AchimPieters/microduck-build/notes/fotos-look-vergelijking.jpg

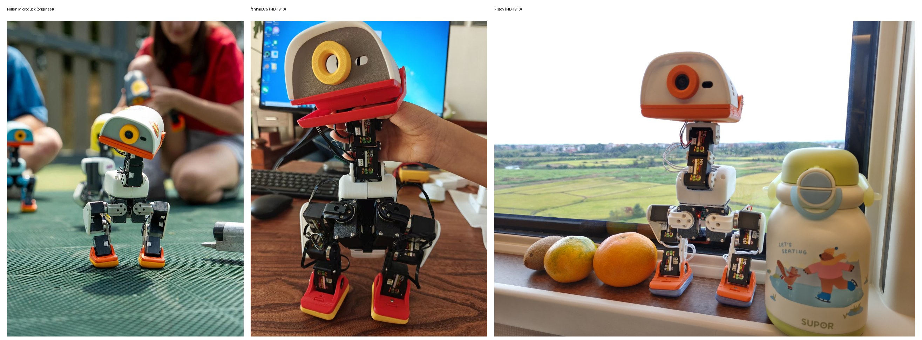
notes/fotos-look-vergelijking.jpg
