AchimPieters/microduck-build/README.md

# Building a micro-Duck

Notes, files and blog drafts for my build of a **Pollen Robotics Microduck** replica, using the [kissqy/Microduck-kissqy](https://github.com/kissqy/Microduck-kissqy) design (Feetech HD-1910 servos, Radxa ZERO 3W).

Website: <https://www.studiopieters.nl>

## The blog series

| Part | Article |
|---|---|
| 1 | [Building a micro-Duck, Part 1: The Plan](https://www.studiopieters.nl/microduck-build-part-1-the-plan/) |
| 2 | [Building a micro-Duck, Part 2: The Hardware](https://www.studiopieters.nl/microduck-build-part-2-the-hardware/) |
| 3 | [Building a micro-Duck, Part 3: Printing the Parts](https://www.studiopieters.nl/microduck-build-part-3-printing-the-parts/) |
| 4 | [Building a micro-Duck, Part 4: Too Many Ducks](https://www.studiopieters.nl/microduck-build-part-4-too-many-ducks/) |
| 5 | [Building a micro-Duck, Part 5: Starting Over, the Right Way](https://www.studiopieters.nl/microduck-build-part-5-starting-over/) |

Parts 1 to 3 describe an earlier plan (the XGO-Duck). From Part 5 on, the build follows the kissqy design.

## What is in this repository

| Folder | Contents |
|---|---|
| `print-files/` | The FrankenDuck 3D print set (36 STL files and a 3MF plate layout) with English file names. `NAME-MAP.txt` lists the original Chinese names. |
| `notes/` | My research notes, build plan and order list (in Dutch). |
| `blog/` | Markdown drafts of Parts 1, 2 and 4. |
| `CLAUDE.md` | Goals, rules and status of the project, used as instructions for Claude Code. |

## Credits and licenses

- The print files, HAT, IMU, HUB, console and walking models are by [kissqy](https://github.com/kissqy/Microduck-kissqy), who allows **personal, non-commercial use only**. See the [license](https://github.com/kissqy/Microduck-kissqy/blob/main/LICENSE). I only renamed the files to English. This repository is private. Check the license before making it public.
- The Microduck is a design by [Pollen Robotics](https://github.com/pollen-robotics/microduck).
- My own notes and drafts are mine.
