AchimPieters/microduck-build/bestellijst-kissqy.md

# Bestellijst: kissqy Microduck (HD-1910)

Opgesteld op 2026-10-31 uit kissqy's [boodschappenlijst](https://github.com/kissqy/Microduck-kissqy/blob/main/DUCK-SHOPPING-LIST.en.md) en bijbehorende gegevens (`docs/build/data.json`). De links verwijzen naar de Taobao- en JD-pagina's van de auteur. Kies op de pagina de **exacte variant (SKU)** uit de kolom "Variant". Prijzen zijn de historische prijzen van de auteur in ¥ en kunnen veranderen. Winkels kunnen uitverkocht raken.

De kosten laat ik buiten beschouwing. Dat hangt af van waar je woont en welke doorstuurservice je kiest.

## A. Via je doorstuurservice (Taobao en JD)

| # | Onderdeel | Aantal | Variant (kies op de pagina) | Link |
|---|---|---:|---|---|
| 1 | Feetech **HD-1910-C001** servo | 15 | HD-1910-C001 | [Taobao](https://item.taobao.com/item.htm?id=1078248851201) |
| 2 | **HAT**, kant-en-klaar | 1 | **AMP2.0-versie** (zie punt hieronder). Bevestig bij de bestelling het type servobus-, speaker- en microfoonconnector | [Taobao](https://item.taobao.com/item.htm?id=1095121548583) |
| 3 | **IMU**, kant-en-klaar (voorgeflasht FT6) | 1 | AMP2.0-versie | zelfde pagina als HAT |
| 4 | Radxa **ZERO 3W** | 1 | 2 GB RAM, geen eMMC, met pinheader (de "Microduck originele" variant) | [Taobao](https://item.taobao.com/item.htm?id=763812025816) |
| 5 | Camera **IMX219 160°** | 1 | "IMX219 160度摄像头" (SKU 6300750750661) | [Taobao](https://item.taobao.com/item.htm?id=1083291197130&skuId=6300750750661) |
| 6 | **ToF 8×8**-module (VL53L5CX) | 1 | "VL53L5X V2 module met afdekglas" | [Taobao](https://item.taobao.com/item.htm?id=737603917521) |
| 7 | Luidspreker | 1 | 3525-behuizing, 4 Ω 3 W. Kies een connector die bij de HAT past | [Taobao](https://item.taobao.com/item.htm?id=683920556900) |
| 8 | Servokabels AMP2.0 3P, **20 cm**, dubbel, omgekeerd | 30 | 200 mm / 1007 / 24 AWG / "双头反向" | [Taobao](https://item.taobao.com/item.htm?id=825340808235) |
| 9 | Servokabels AMP2.0 3P, **10 cm**, dubbel, omgekeerd | 30 | 100 mm / 1007 / 24 AWG / "双头反向" | zelfde pagina |
| 10 | Kabel SH1.0 4P naar Dupont (voor de ToF) | 1 set (5) | 0,2 m, SH1.0 4P | [Taobao](https://item.taobao.com/item.htm?id=895049863252) |
| 11 | Lagers **6700** (10 × 15 × 3 mm) | 5 | "6700 open", lagerstaal | [Taobao](https://item.taobao.com/item.htm?id=625390659071) |
| 12 | Lagers **ET2216** (16 × 22 × 4 mm) | 12 | "ET2216", lagerstaal | [Taobao](https://item.taobao.com/item.htm?id=733598659967) |
| 13 | Schroeven, zelftappend, kruiskop, plat uiteinde | 6 zakken van 200 | M2×4, M2×5, M2×6, M2×8, M2×12 en M2.6×8. Eén pagina, zes varianten | [Taobao](https://item.taobao.com/item.htm?id=534923831046) |
| 14 | Servo-programmeerbord **Feetech URT2** | 1 | URT2 (voor het instellen van servo-ID's) | [Taobao](https://item.taobao.com/item.htm?abbucket=0&id=603181554943&skuId=4836538640319) |
| 15 | Gekleurde krimpkous | 1 zak (164 stuks) | "2× krimp" | [Taobao](https://item.taobao.com/item.htm?id=945215173380) |

**Lokaal te koop in plaats van via Taobao (scheelt gewicht en gedoe):** microSD-kaart 32 GB, kaartlezer (als je er geen hebt), krimpkous.

**Let op, AMP2.0 of EH2.5:** de HAT en IMU bestaan in twee connectorversies. Kissqy's boodschappenlijst en prijzen gelden voor de oorspronkelijke **EH2.5**-versie. De HD-1910-servo's en de kabels in de lijst gebruiken **AMP2.0**. Bestel dus de **AMP2.0**-versie van HAT en IMU en lees de [AMP2.0-pagina](https://github.com/kissqy/Microduck-kissqy/blob/main/hardware/AMP2.0-VERSION.en.md) voor de extra aansluitingen (HP1.25 voor speaker en microfoon).

## B. In Nederland kopen

| Onderdeel | Aantal | Opmerking |
|---|---:|---|
| Sony **NP-F550**-accu | 2 | 2000–2200 mAh |
| Dubbele lader voor NP-F serie | 1 | USB-C of netvoeding |
| Gamepad, Xbox-modus en Bluetooth | 1 | GameSir Nova 2 Lite. Zet hem in Xbox-modus. |
| TPU-filament 95A | 250 g | Voor de twee zolen |
| PLA-filament | ca. 1 kg of meer | Kleuren naar keuze, zie `bouwplan-kissqy.md` |

## C. Vragen aan de verkoper (kissqy)

1. Verkoop je de **HUB** (DXL_HUB_V2, met condensator van 1000 µF)? Naar welke versie moet ik bestellen?
2. Welk onderdeel levert de **accucontacten** voor de NP-F550-houder, en verkoop je dat?
3. Welke versie van HAT en IMU past bij **AMP2.0-servokabels**? Zit de speakerconnector erbij?
4. Kan alles samen naar mijn **doorstuurmagazijn**?

Een kant-en-klaar bericht staat in `bouwplan-kissqy.md`.

## D. Gereedschap

Kissqy noemt gewoon assemblagegereedschap: passende kruiskopschroevendraaiers, striptang en isolatiemateriaal, en een multimeter om doorgang te controleren. Je hebt waarschijnlijk veel al. Solderen is niet nodig, want de HAT en IMU komen gemonteerd.

## E. Nog niet gevonden

- HUB: geen koopverwijzing (zie C).
- Accucontacten: onderdeel onbekend (zie C).
