AchimPieters/microduck-build/print-files/FrankenDuck-plate-layout.3mf

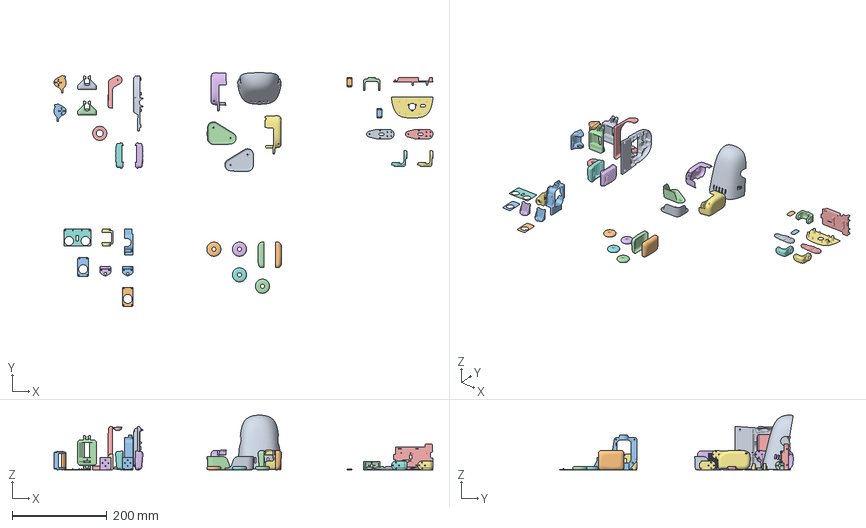
[picture p2: CAD file, 2026-10-31]
print-files/FrankenDuck-plate-layout.3mf
799.0 x 492.5 x 115.6 mm
bottom_head_shell_rear_M2_counterbore_D4p2_depth5mm.stl
sole_right.stl
motor_support.stl
sole_left.stl
power_support_IMU_clip_R8_correct_beam_up2mm_M2p5.stl
tire_623_TPU_dual_lips_1p8mm.stl x 4
yaw_roll_motion_gap21mm_M2_depth2mm_bottom_inner_minus2mm.stl
top_head_shell_vents_R3_rounded_long_slots_mm.stl
yaw2roll_FT_center_D6_depth1mm.stl x 2
jaw.stl
face_part_IMX219_camera7mm_outer12mm.stl
trunk_base.stl
roller_blade_clean_mount_horizontal_beam_M2.stl x 2
bearing_roll.stl x 2
leg_outer_M2_depth2mm_original_inner_bore - 1.stl
foot_right.stl
left_shell_左壳.stl
foot_left.stl
leg_outer_M2_depth2mm_original_inner_bore.stl
ankle_left_arc_v1_结果_mesh
ankle_right_arc_v1_结果_mesh
neck_pitch_R5_counterbores_shallower0p5mm.stl
noenoeil_3xD1p6_blind_depth5_backwall2mm.stl
right_shell_右壳.stl
hip_l - 1.stl
hip_l.stl
left_upper_leg_no_pins_outer_plain_holes.stl
neck_颈部.stl.stl
neck_颈部.stl(1).stl
right_upper_leg_no_pins_outer_plain_holes.stl
