AchimPieters/microduck-build/print-files/stl-models/black-parts/left-leg-retainer-plate.stl

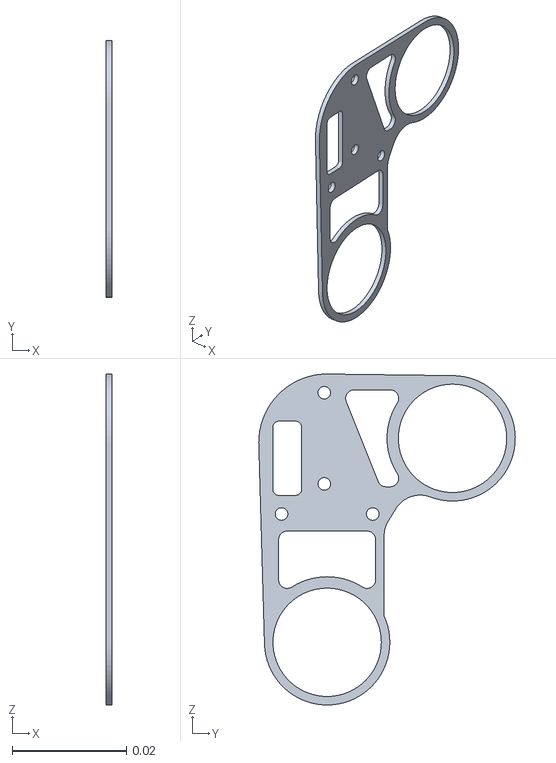
[picture p3: CAD file, 2026-10-31]
print-files/stl-models/black-parts/left-leg-retainer-plate.stl
0.001 x 0.045 x 0.0581
