AchimPieters/microduck-build/print-files/stl-models/body-parts/right-shell.stl

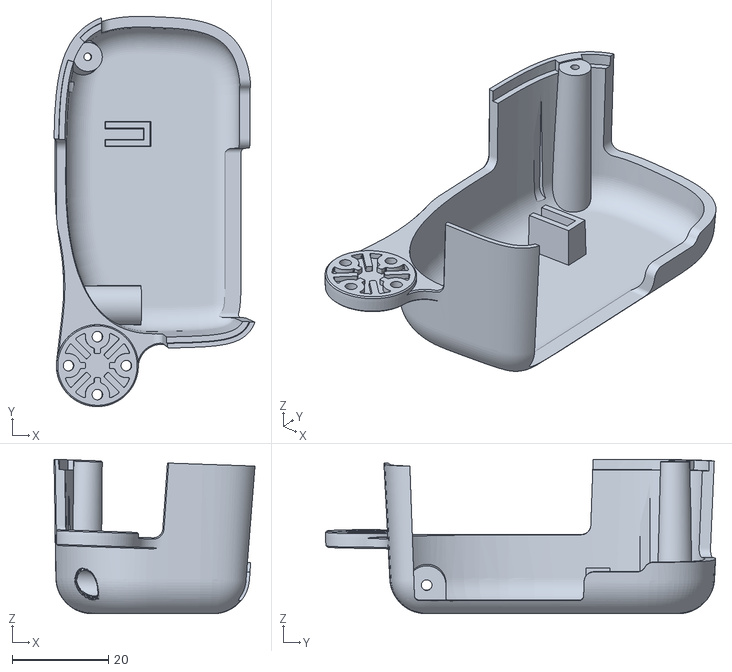
[picture p4: CAD file, 2026-10-31]
print-files/stl-models/body-parts/right-shell.stl
41.7 x 80.9 x 32.0
