AchimPieters/microduck-build/print-files/stl-models/orange-parts/left-foot.stl

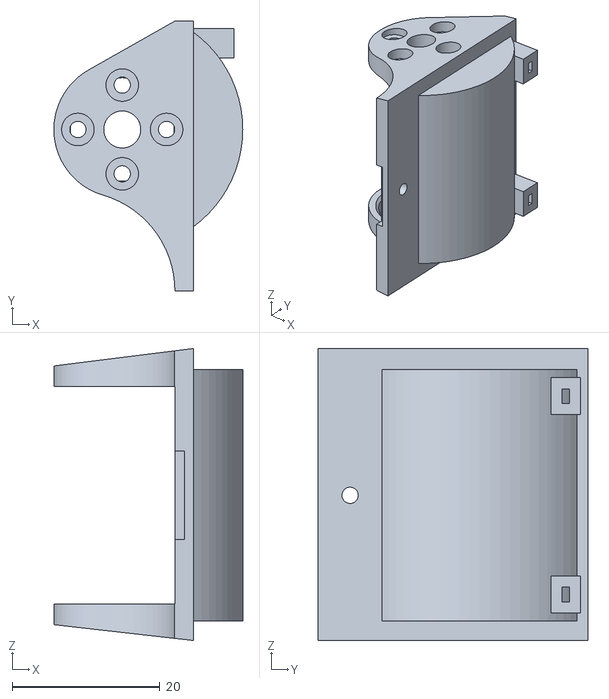
[picture p5: CAD file, 2026-10-31]
print-files/stl-models/orange-parts/left-foot.stl
25.5 x 36.5 x 39.5
