AchimPieters/microduck-build/print-files/stl-models/support-parts/left-knee-support.stl

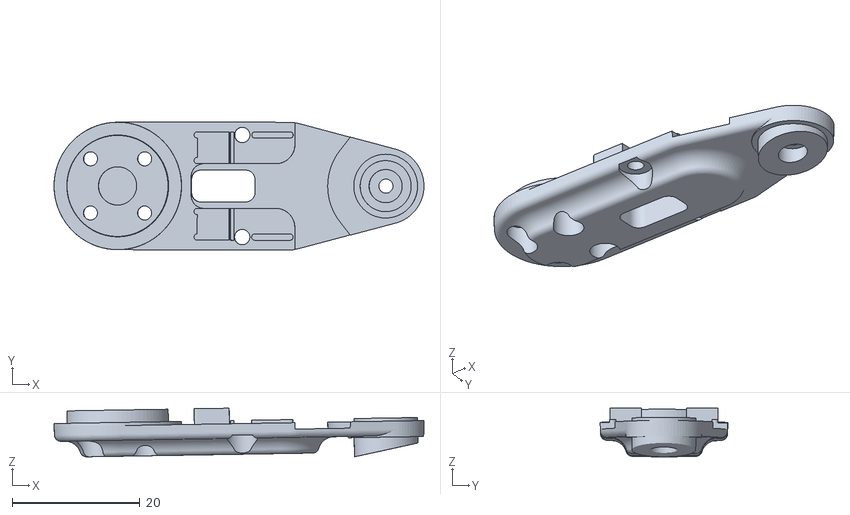
[picture p6: CAD file, 2026-10-31]
print-files/stl-models/support-parts/left-knee-support.stl
58.0 x 20.0 x 7.63
