AchimPieters/microduck-build/print-files/stl-models/TPU-parts/left-sole-TPU.stl

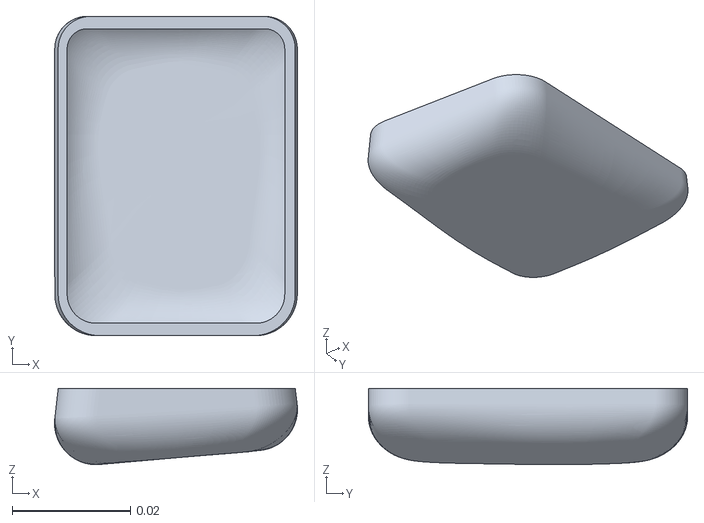
[picture p7: CAD file, 2026-10-31]
print-files/stl-models/TPU-parts/left-sole-TPU.stl
0.0411 x 0.054 x 0.0129
