AchimPieters/microduck-build/print-files/stl-models/black-parts/head-integrated-cover.stl

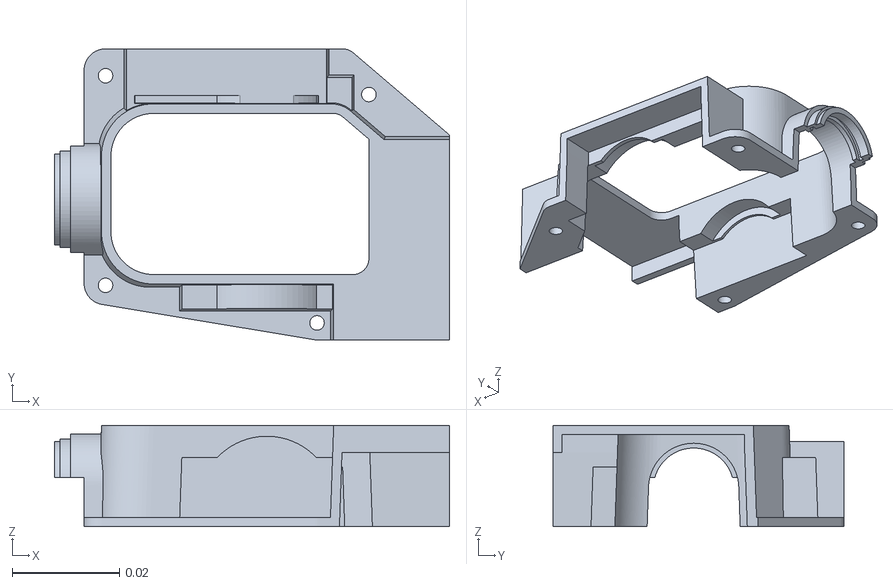
[picture p8: CAD file, 2026-10-31]
print-files/stl-models/black-parts/head-integrated-cover.stl
0.0735 x 0.0542 x 0.0188
