AchimPieters/microduck-build/print-files/stl-models/orange-parts/head-integrated-plate.stl

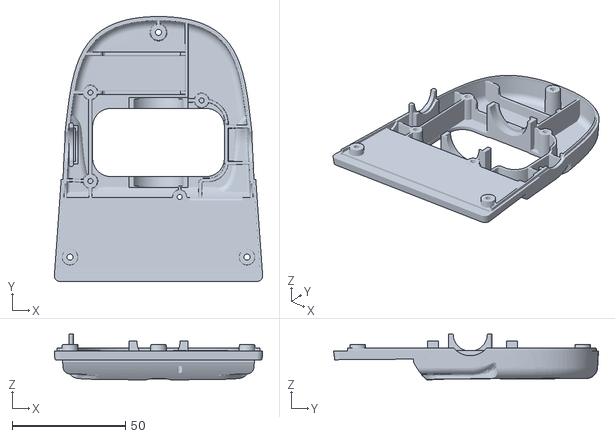
[picture p9: CAD file, 2026-10-31]
print-files/stl-models/orange-parts/head-integrated-plate.stl
91.8 x 116.7 x 20.1
