AchimPieters/microduck-build/print-files/stl-models/support-parts/head-rotation.stl

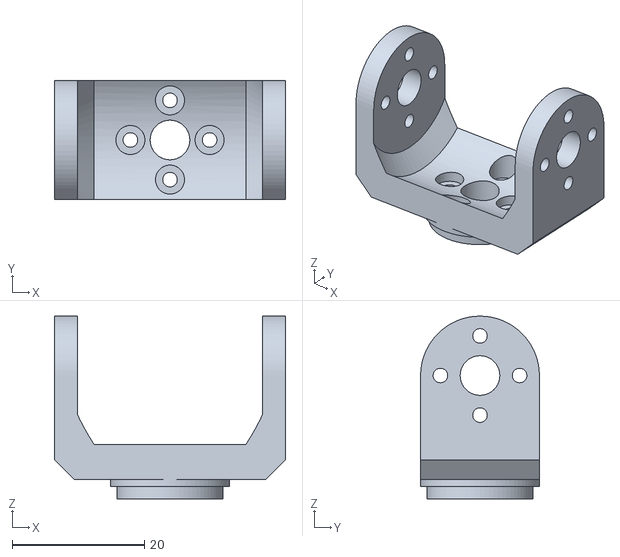
[picture p10: CAD file, 2026-10-31]
print-files/stl-models/support-parts/head-rotation.stl
35.0 x 18.0 x 27.7
