AchimPieters/microduck-build/print-files/stl-models/black-parts/left-hip-rotation.stl

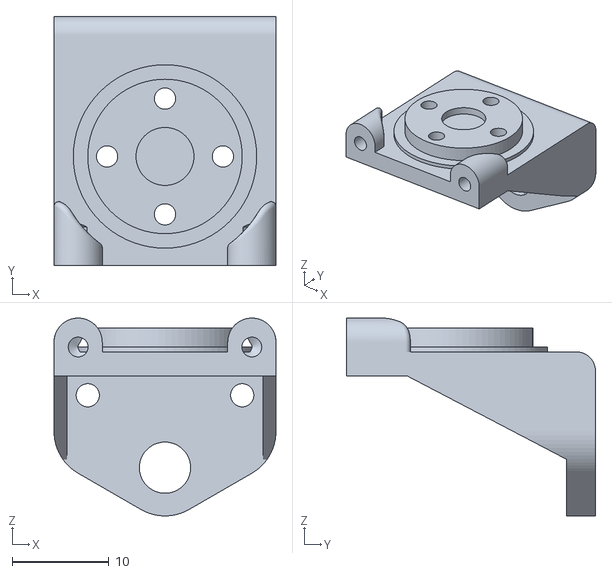
[picture p11: CAD file, 2026-10-31]
print-files/stl-models/black-parts/left-hip-rotation.stl
23.0 x 25.8 x 20.5
