AchimPieters/microduck-build/print-files/stl-models/body-parts/head-cover.stl

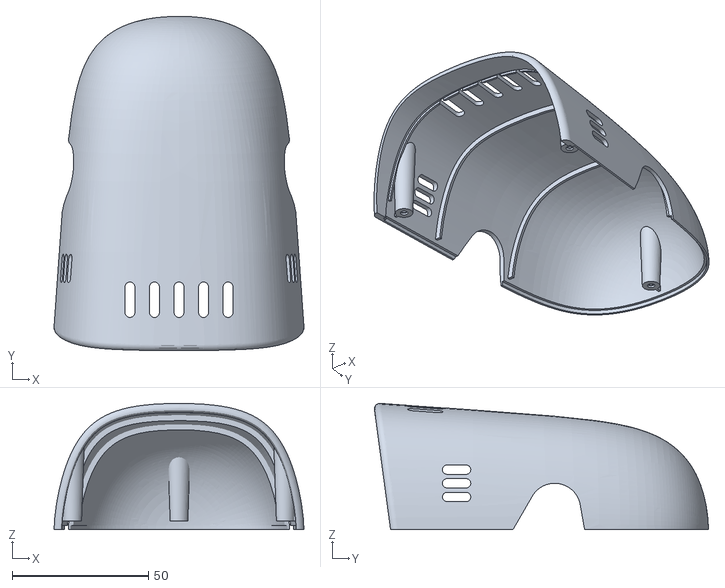
[picture p12: CAD file, 2026-10-31]
print-files/stl-models/body-parts/head-cover.stl
91.8 x 122.7 x 46.3
