AchimPieters/microduck-build/print-files/stl-models/orange-parts/left-footpad.stl

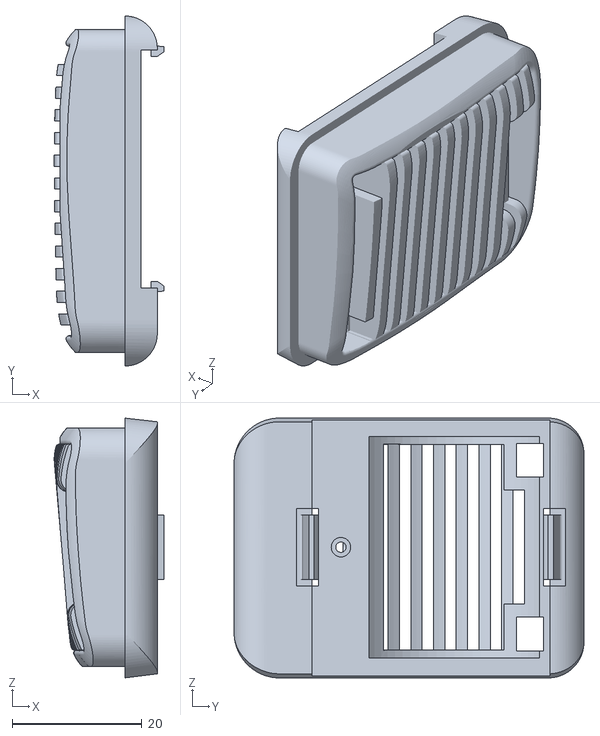
[picture p13: CAD file, 2026-10-31]
print-files/stl-models/orange-parts/left-footpad.stl
16.9 x 54.0 x 40.1
