AchimPieters/microduck-build/print-files/stl-models/support-parts/neck-mount-left.stl

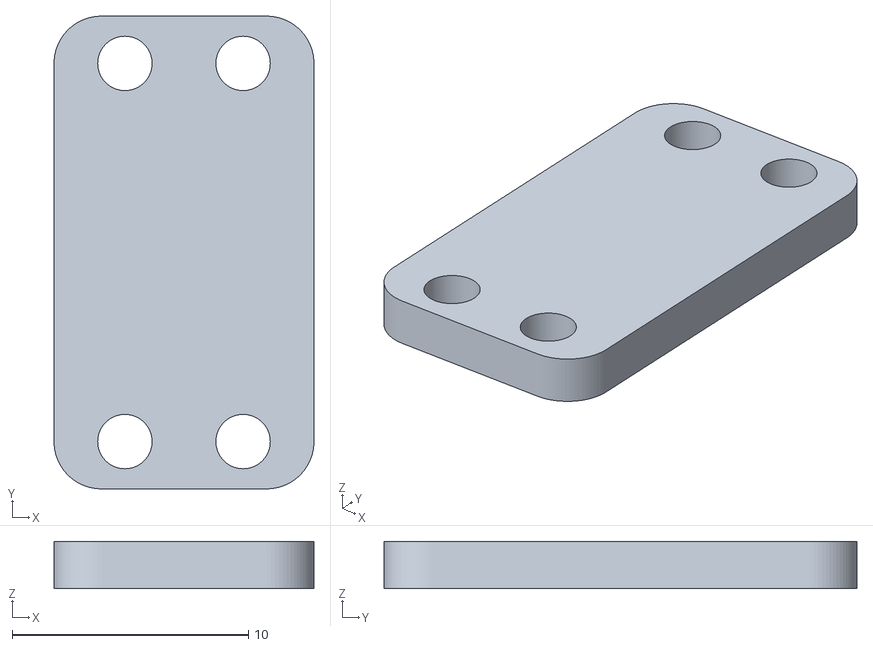
[picture p14: CAD file, 2026-10-31]
print-files/stl-models/support-parts/neck-mount-left.stl
11.0 x 20.0 x 2.00
