AchimPieters/microduck-build/print-files/stl-models/TPU-parts/roller-wheel.stl

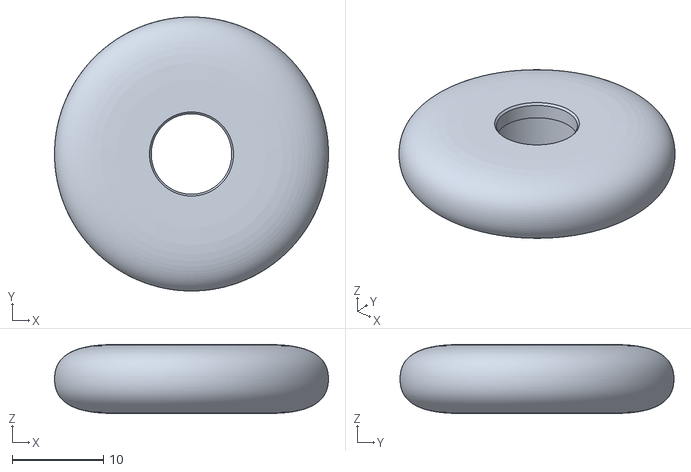
[picture p15: CAD file, 2026-10-31]
print-files/stl-models/TPU-parts/roller-wheel.stl
30.0 x 30.0 x 7.60
