AchimPieters/microduck-build/print-files/stl-models/body-parts/left-hip-outer-cover.stl

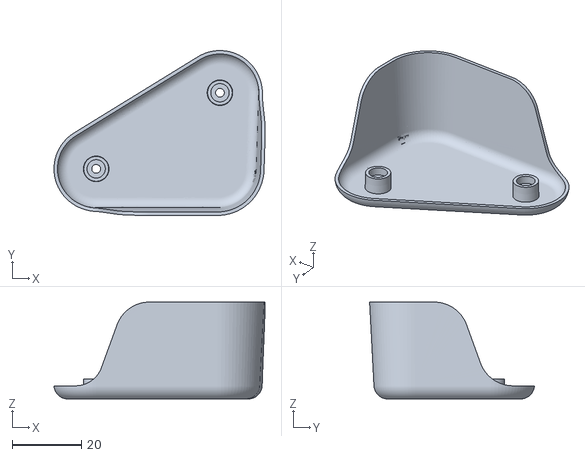
[picture p16: CAD file, 2026-10-31]
print-files/stl-models/body-parts/left-hip-outer-cover.stl
61.0 x 47.7 x 28.0
