AchimPieters/microduck-build/print-files/stl-models/orange-parts/beak.stl

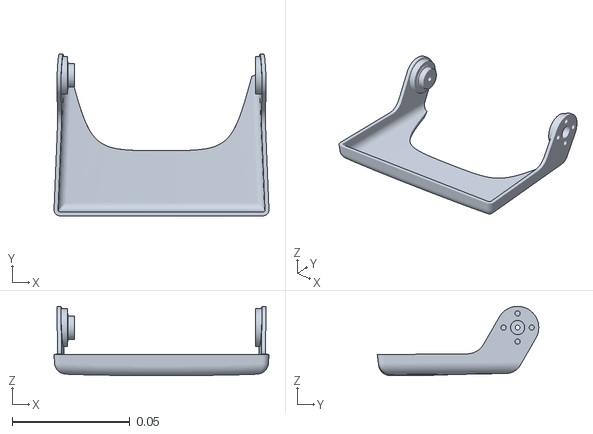
[picture p17: CAD file, 2026-10-31]
print-files/stl-models/orange-parts/beak.stl
0.0914 x 0.0687 x 0.0294
