AchimPieters/microduck-build/print-files/stl-models/black-parts/right-hip-retainer-plate.stl

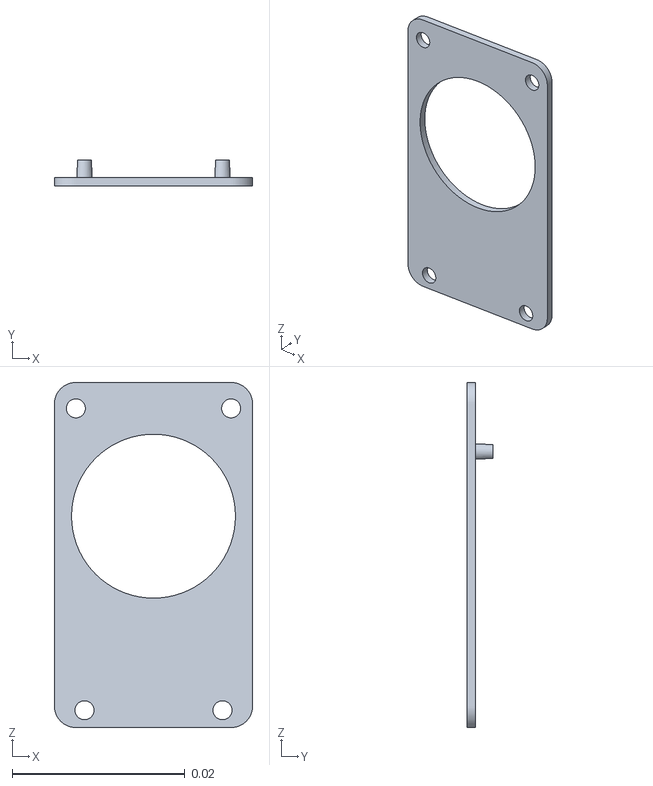
[picture p18: CAD file, 2026-10-31]
print-files/stl-models/black-parts/right-hip-retainer-plate.stl
0.023 x 0.003 x 0.04
