AchimPieters/microduck-build/print-files/stl-models/body-parts/battery-holder_thick-clips.stl

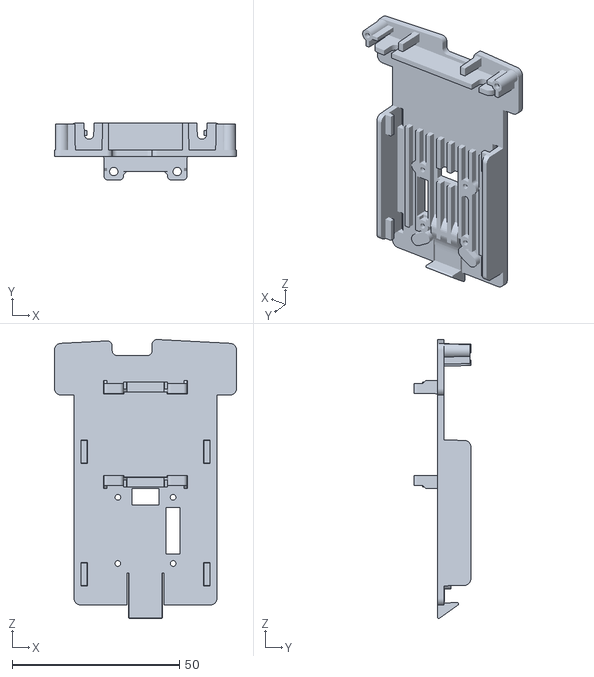
[picture p19: CAD file, 2026-10-31]
print-files/stl-models/body-parts/battery-holder_thick-clips.stl
54.5 x 17.0 x 83.5
