AchimPieters/microduck-build/print-files/stl-models/orange-parts/eyes.stl

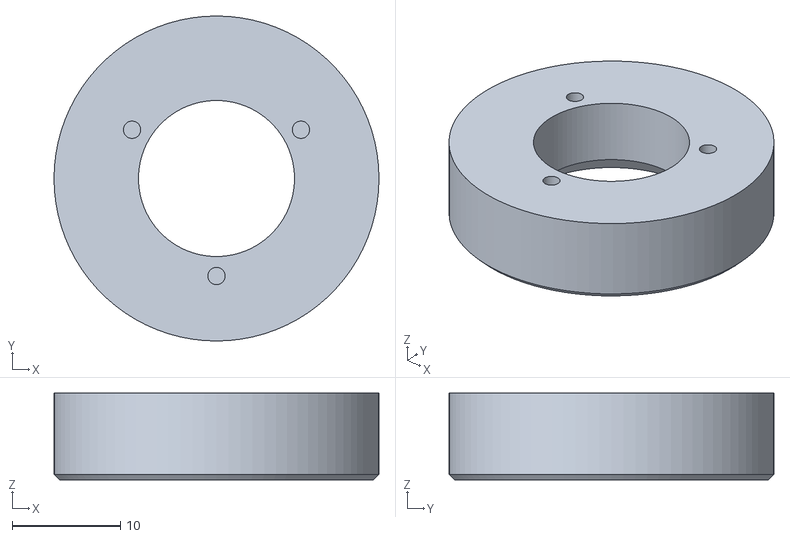
[picture p20: CAD file, 2026-10-31]
print-files/stl-models/orange-parts/eyes.stl
30.0 x 30.0 x 8.00
