AchimPieters/microduck-build/print-files/stl-models/black-parts/trunk-base.stl

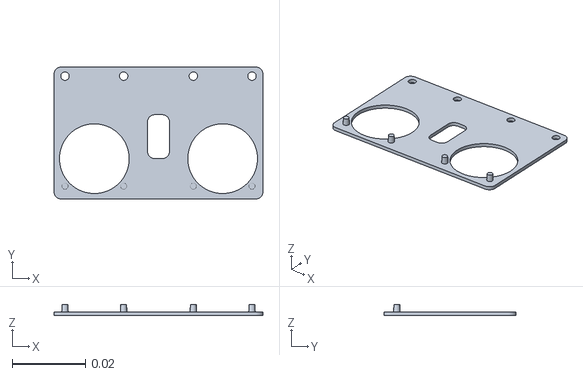
[picture p21: CAD file, 2026-10-31]
print-files/stl-models/black-parts/trunk-base.stl
0.057 x 0.036 x 0.003
