AchimPieters/microduck-build/print-files/stl-models/body-parts/left-shell.stl

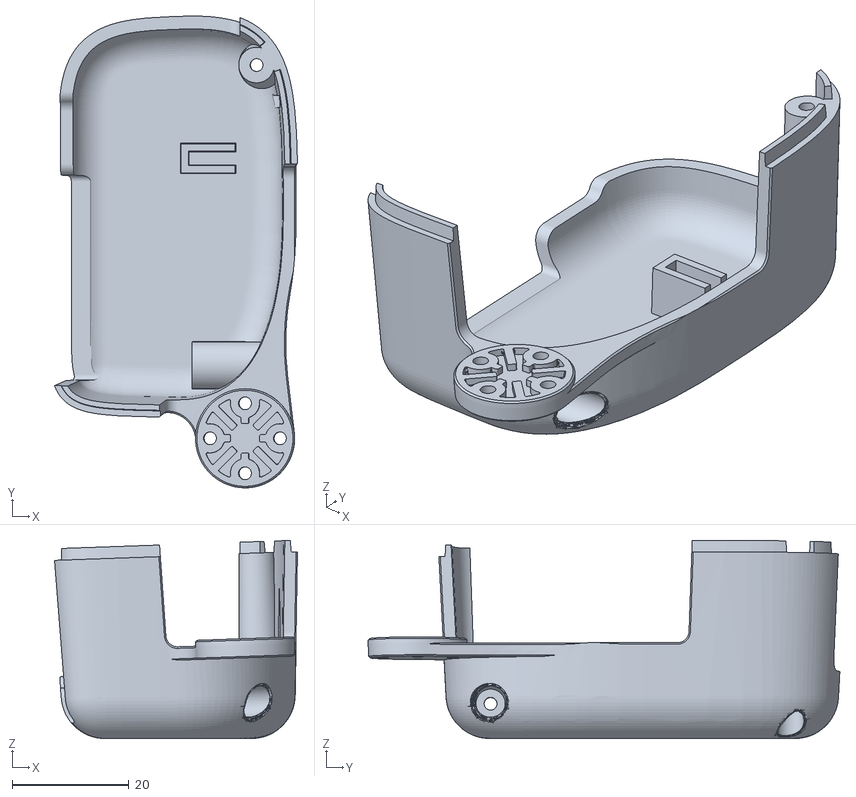
[picture p22: CAD file, 2026-10-31]
print-files/stl-models/body-parts/left-shell.stl
41.7 x 80.9 x 34.0
