AchimPieters/microduck-build/print-files/stl-models/support-parts/right-hip-swing.stl

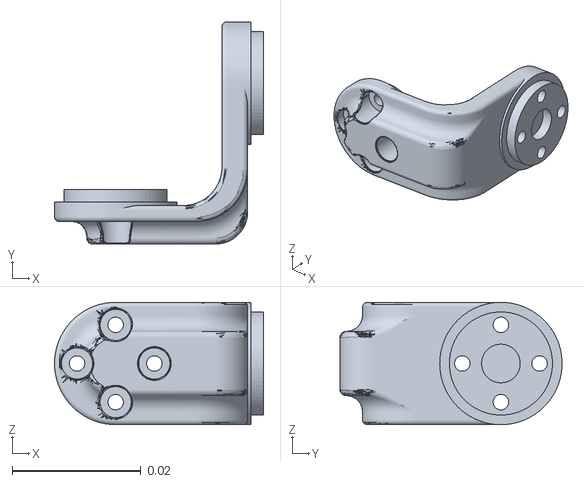
[picture p23: CAD file, 2026-10-31]
print-files/stl-models/support-parts/right-hip-swing.stl
0.0325 x 0.0345 x 0.019
