AchimPieters/microduck-build/print-files/stl-models/black-parts/head-roll.stl

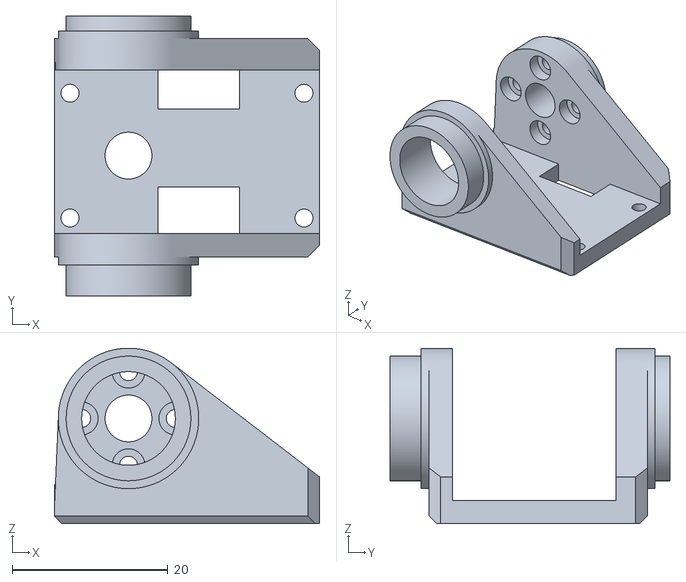
[picture p24: CAD file, 2026-10-31]
print-files/stl-models/black-parts/head-roll.stl
34.0 x 35.9 x 22.5
