AchimPieters/microduck-build/print-files/stl-models/orange-parts/roller-bracket-left.stl

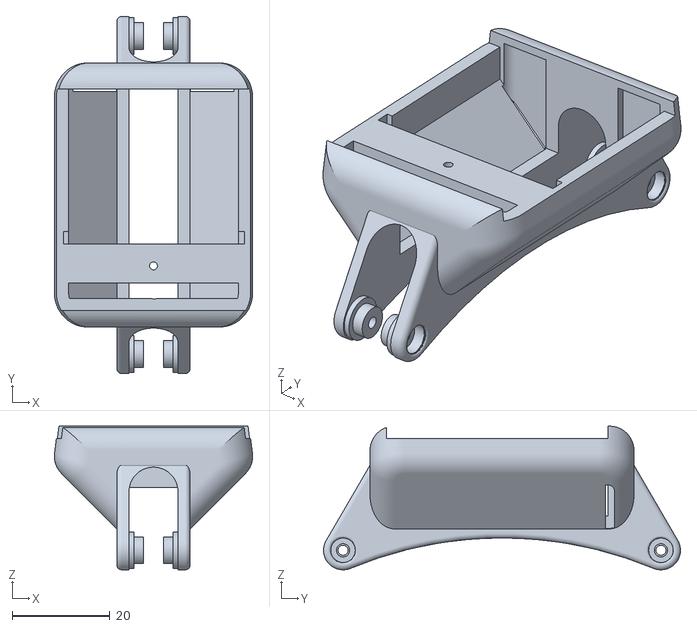
[picture p25: CAD file, 2026-10-31]
print-files/stl-models/orange-parts/roller-bracket-left.stl
40.5 x 73.0 x 29.4
