AchimPieters/microduck-build/print-files/stl-models/support-parts/face.stl

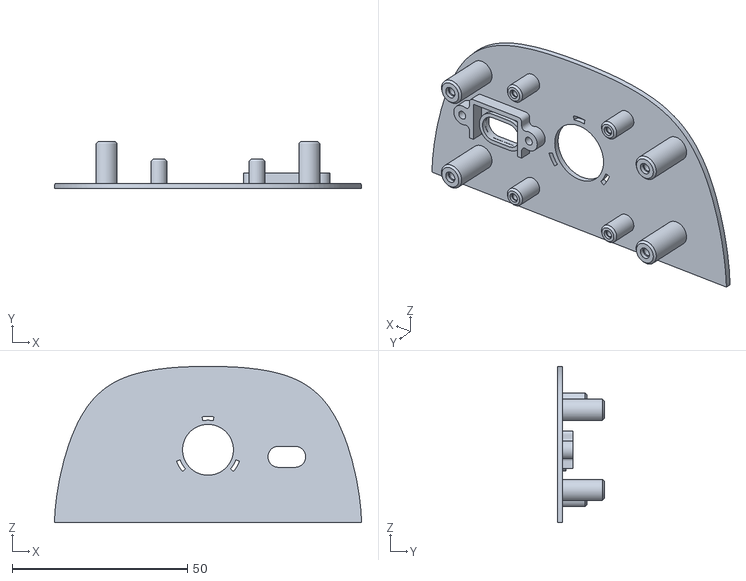
[picture p26: CAD file, 2026-10-31]
print-files/stl-models/support-parts/face.stl
87.7 x 13.3 x 44.6
