AchimPieters/microduck-build/(list of files, cad)

Other CAD files:
print-files/stl-models/TPU-parts/right-sole-TPU.stl
print-files/stl-models/support-parts/neck-mount-right.stl
print-files/stl-models/orange-parts/right-footpad.stl
print-files/stl-models/body-parts/right-hip-outer-shell.stl
print-files/stl-models/orange-parts/right-foot.stl
print-files/stl-models/body-parts/battery-holder_M2.5-screws_HUB-combo.stl
